rohanbhadange/RTX-AVC-Design/ATTRIBUTION.md

# CAD sources and ownership

This archive contains project CAD and manufacturer/supplier reference geometry. Third-party ownership and any original terms remain with the respective owners. Publication here does not grant a new license or relicense vendor assets. No blanket software or CAD license is asserted for this mixed-source archive.

Native filenames, source directory relationships and CAD bytes are preserved. Imported native assemblies may contain manufacturer component names or historical source-path fragments. Some project representations are envelopes, simplified extractions or standard-hardware approximations; their presence does not establish supplier approval or as-built accuracy.

Identifiable source families include Holybro flight-controller/compute/power hardware, Intel RealSense D455, NVIDIA/Seeed compute geometry, T-Motor propulsion references, Pololu regulators, Basicmicro RoboClaw, Lyn-Tron spacers and standard mounting hardware. Individual component rights remain with their respective owners, including subcomponents in imported supplier assemblies.

Known source/reference sites, supplied for attribution rather than as license grants:

| Source family | Reference |
| --- | --- |
| Holybro power-module/PDB source downloads | https://docs.holybro.com/power-module-and-pdb/power-module/download |
| Holybro flight-controller/compute products | https://holybro.com/ |
| Intel RealSense reference family | https://www.intelrealsense.com/ |
| NVIDIA Jetson reference family | https://developer.nvidia.com/embedded/ |
| Seeed reComputer reference family | https://www.seeedstudio.com/ |
| T-Motor reference family | https://uav-en.tmotor.com/ |
| Pololu reference family | https://www.pololu.com/ |
| Basicmicro reference family | https://www.basicmicro.com/ |
| Lyn-Tron spacer reference family | https://www.lyntron.com/ |

The exact raw exchange sources retained alongside their native counterparts are `Holybro_PDB_18139.step`, `Holybro_PM08_CAN_Case_v003.step`, and `Holybro_Pixhawk_Jetson_11072.step` under `cad/DronePlayground/WORKING/R3_1/VENDOR/`. Their filenames and hashes are recorded in the manifest. No local LICENSE, NOTICE or COPYING files were found in the supplied DronePlayground tree during this checkpoint review; this is not a determination that third-party CAD is unrestricted.
