rohanbhadange/RTX-AVC-Design/CHECKPOINT.md

# Drone Playground engineering checkpoint

Saved baseline: C124, configuration R3_3_PACKAGING. This checkpoint preserves the existing integrated drone assembly. The configuration was saved with SolidWorks error/warning status 0/0 and 82 baseline root signatures preserved. No optimized candidate geometry is installed in this baseline.

The baseline includes the internal power cassette work. The external PM08 arrangement and USB storage fallback remain. Native represented mass is provisional and is not a verified aircraft mass or flight-margin result.

Separate work in progress includes lower/upper plate lightening candidates and a camera-yoke candidate. These are uninstalled studies; candidate mass reductions are not installed aircraft savings. Local geometry and contact screens do not establish structural strength, cable routing, manufacturing readiness or flight qualification.

Packaging and full system integration remain incomplete. Open work includes complete power protection and disconnect interfaces, actual cable/connector retention and harness routing, compute/storage and sensor/radio integration, manufacturing and mechanical load qualification, mass/CG reconciliation, and operating-state and fault-response verification. All previously tracked integration obligations remain open until individually verified.

Any accompanying C122 native views show the earlier internal-power integration state. They are historical views and do not depict installed R3.3 optimizations.
