rohanbhadange/RTX-AVC-Design/cad/DronePlayground/WORKING/R3_1/exports/C178_Compute_Radio_Module.png

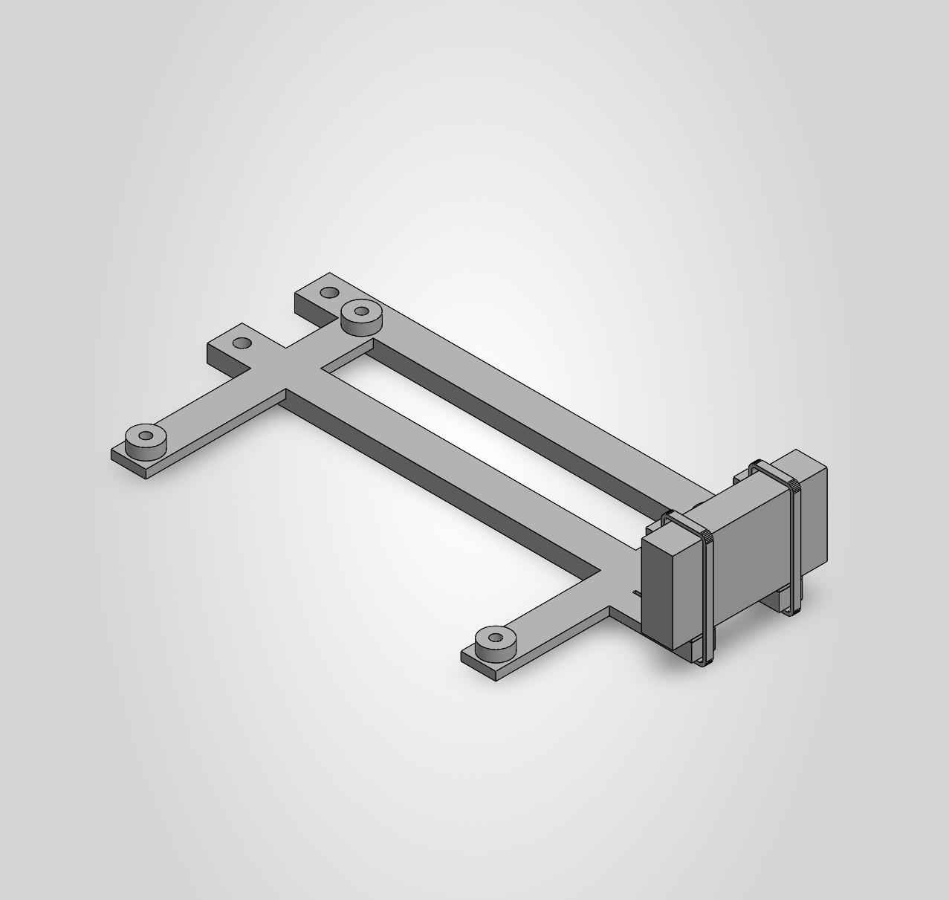
cad/DronePlayground/WORKING/R3_1/exports/C178_Compute_Radio_Module.png
