rohanbhadange/RTX-AVC-Design/cad/DronePlayground/WORKING/R3_1/exports/C180_Radio_Integrated_isometric.png

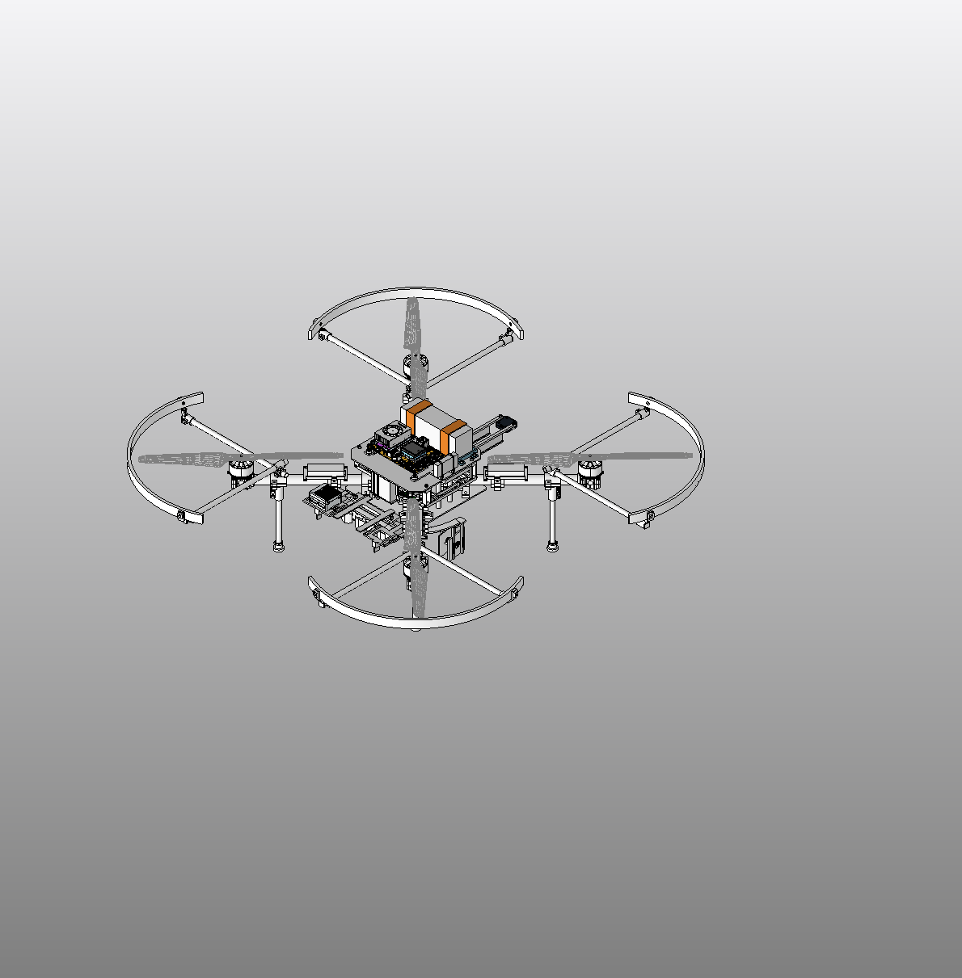
cad/DronePlayground/WORKING/R3_1/exports/C180_Radio_Integrated_isometric.png
