rohanbhadange/RTX-AVC-Design/cad/DronePlayground/WORKING/R3_1/exports/C203_Internal_PM08_Module.png

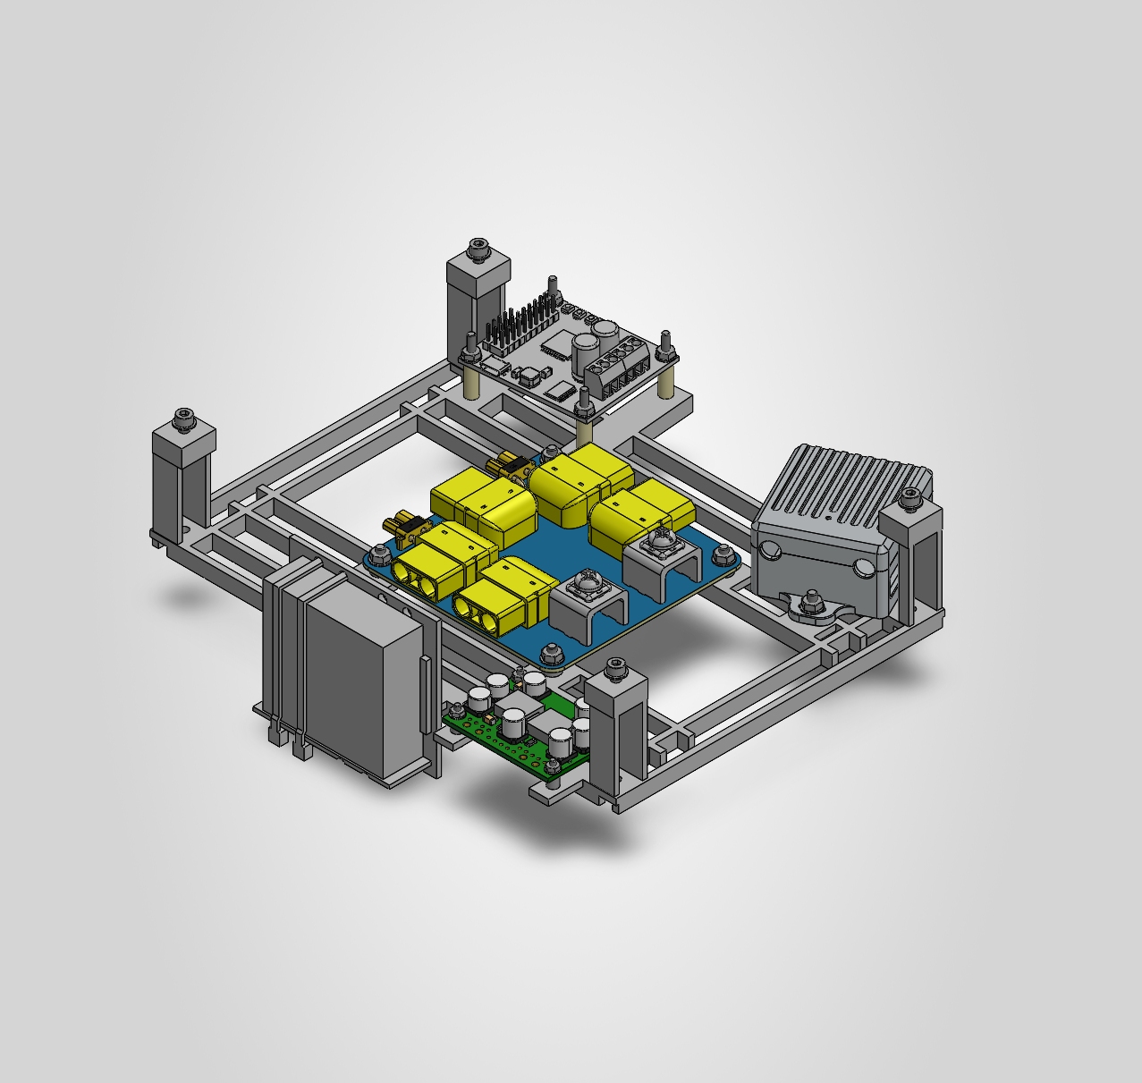
cad/DronePlayground/WORKING/R3_1/exports/C203_Internal_PM08_Module.png
