rohanbhadange/RTX-AVC-Design/diagrams/presentation/01-power-distribution.png

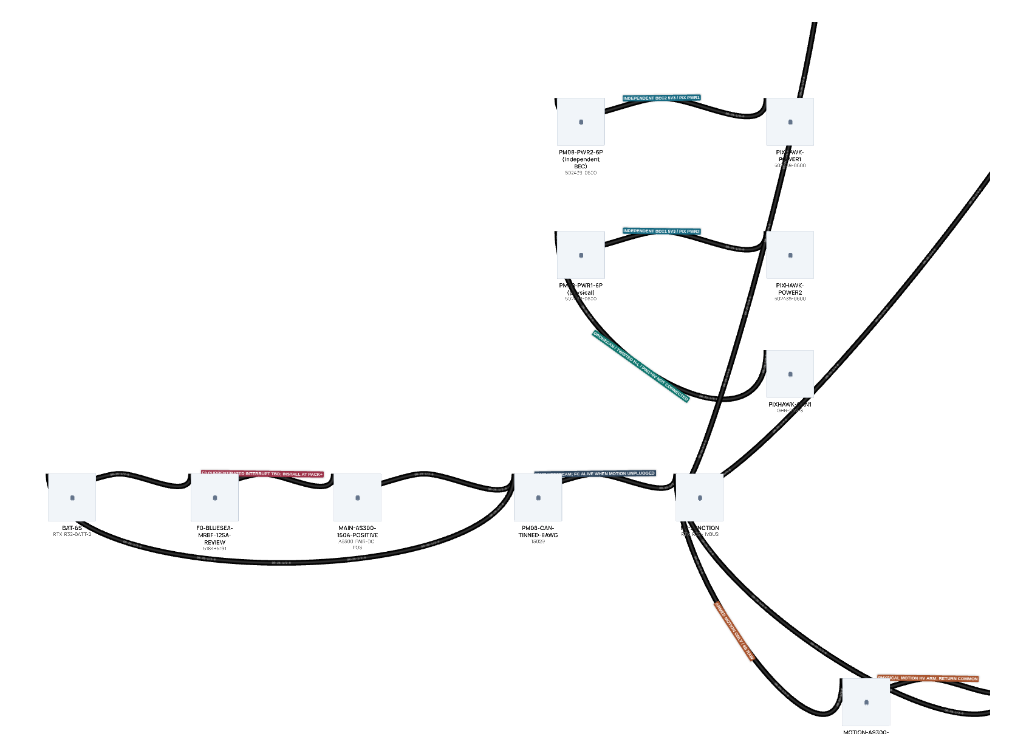
diagrams/presentation/01-power-distribution.png
