rohanbhadange/RTX-AVC-Design/diagrams/presentation/02-compute-brainchip.png

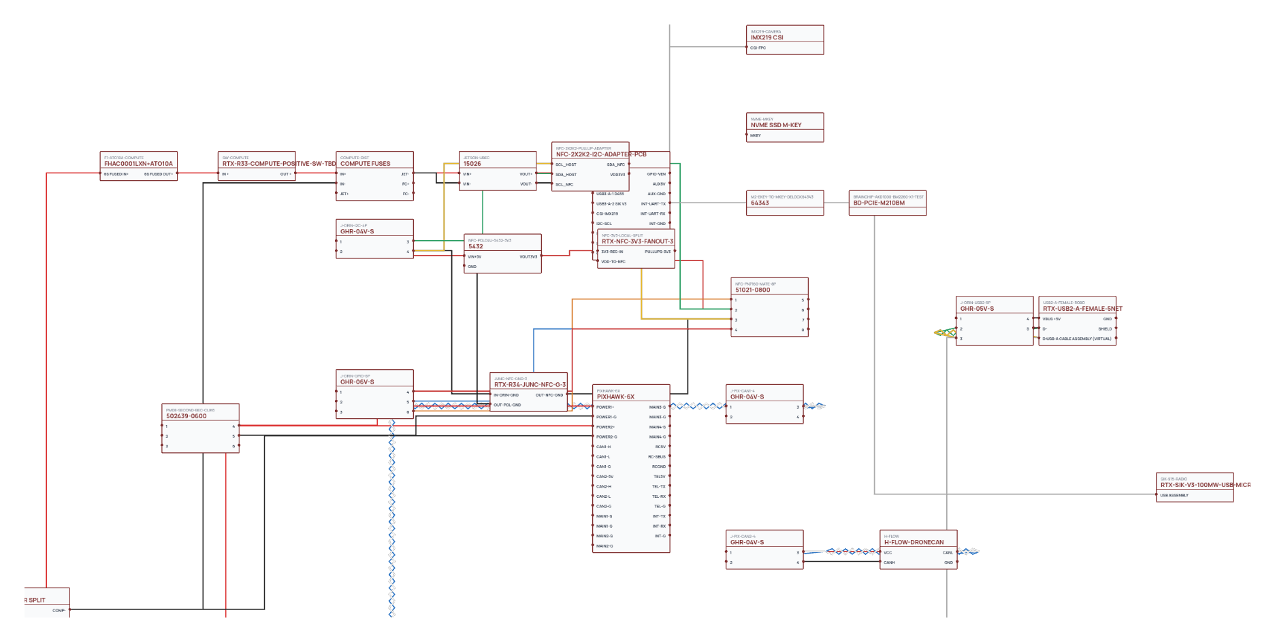
diagrams/presentation/02-compute-brainchip.png
