rohanbhadange/RTX-AVC-Design/diagrams/presentation/03-comms-sensors.png

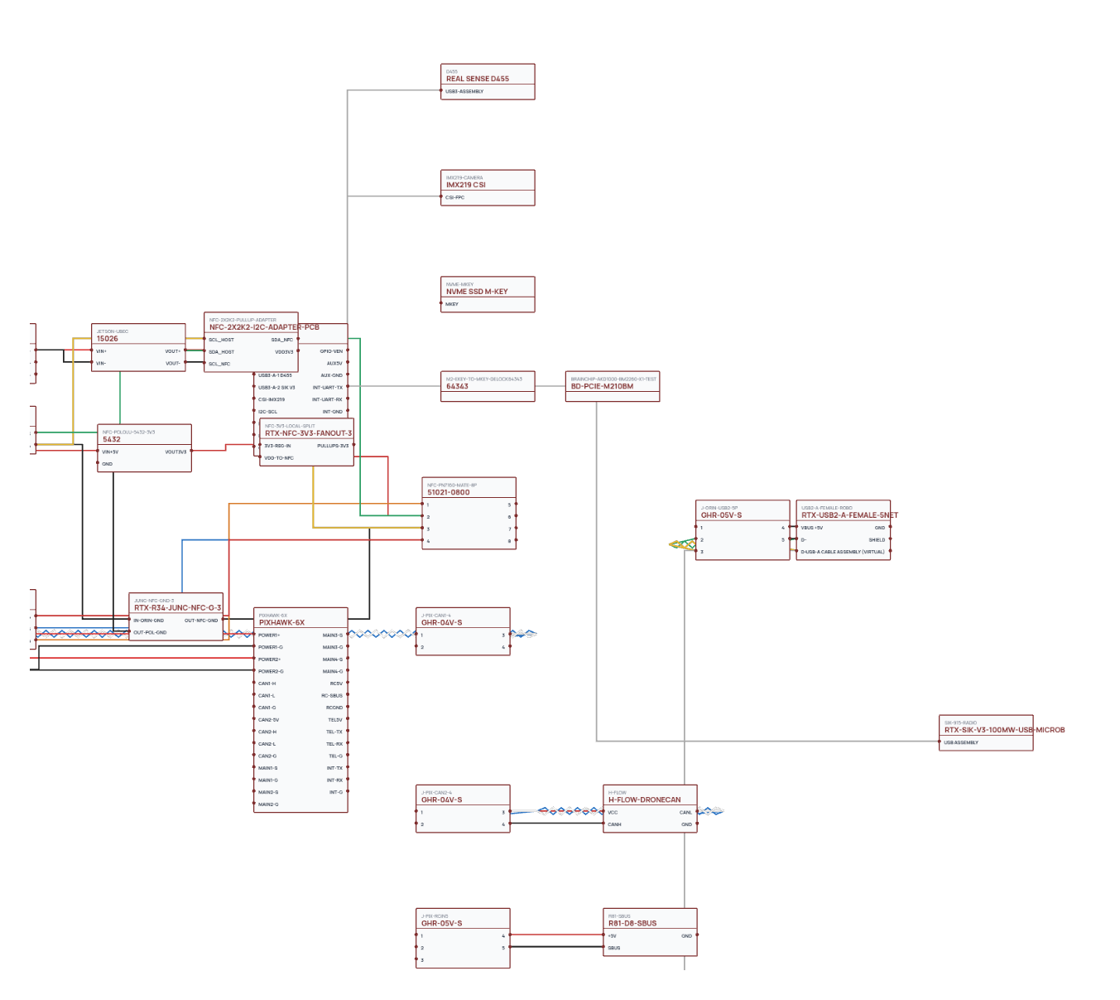
diagrams/presentation/03-comms-sensors.png
