rohanbhadange/RTX-AVC-Design/diagrams/presentation/04-propulsion.png

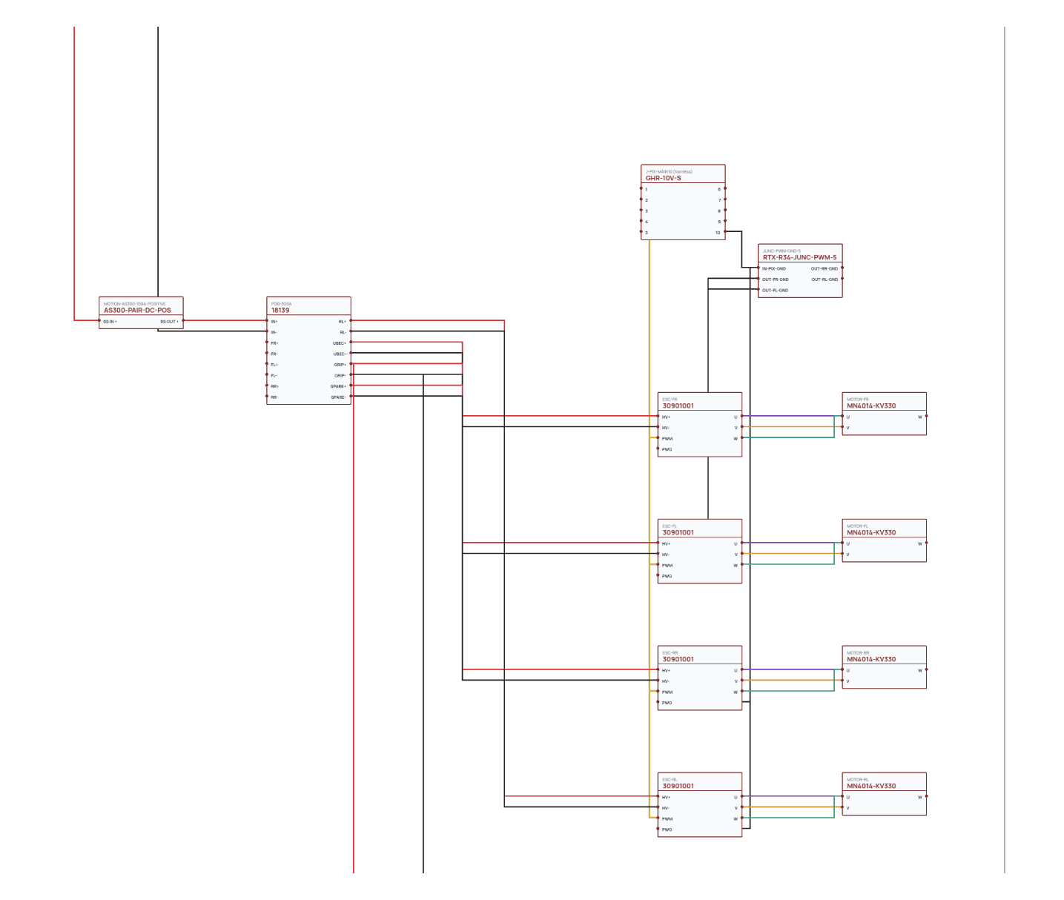
diagrams/presentation/04-propulsion.png
