rohanbhadange/RTX-AVC-Design/diagrams/presentation/05-gripper-control.png

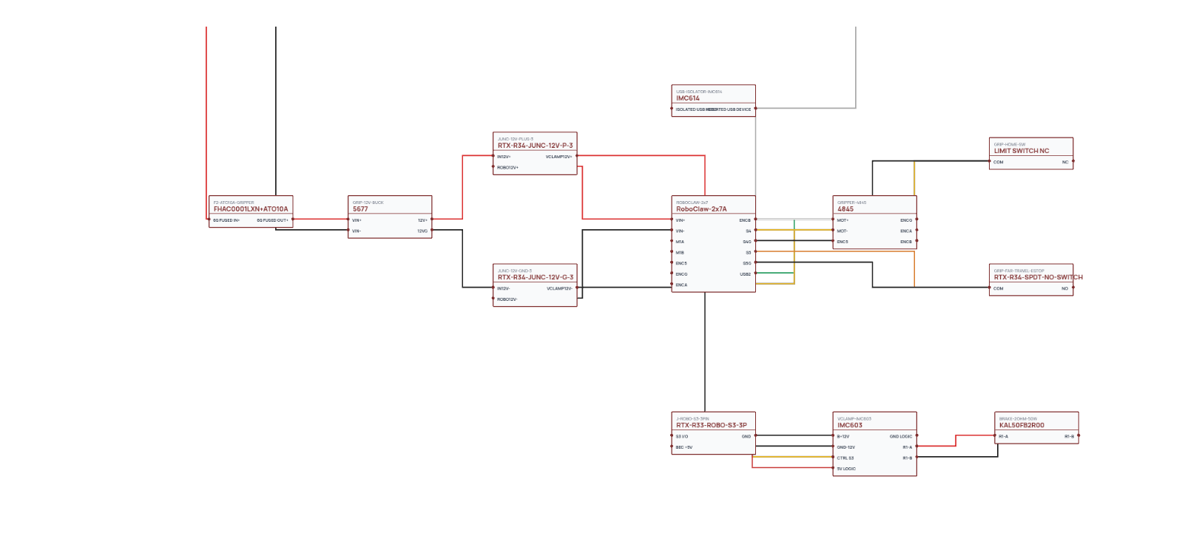
diagrams/presentation/05-gripper-control.png
