rohanbhadange/RTX-AVC-Design/diagrams/wiring-studio/W-100-design.png

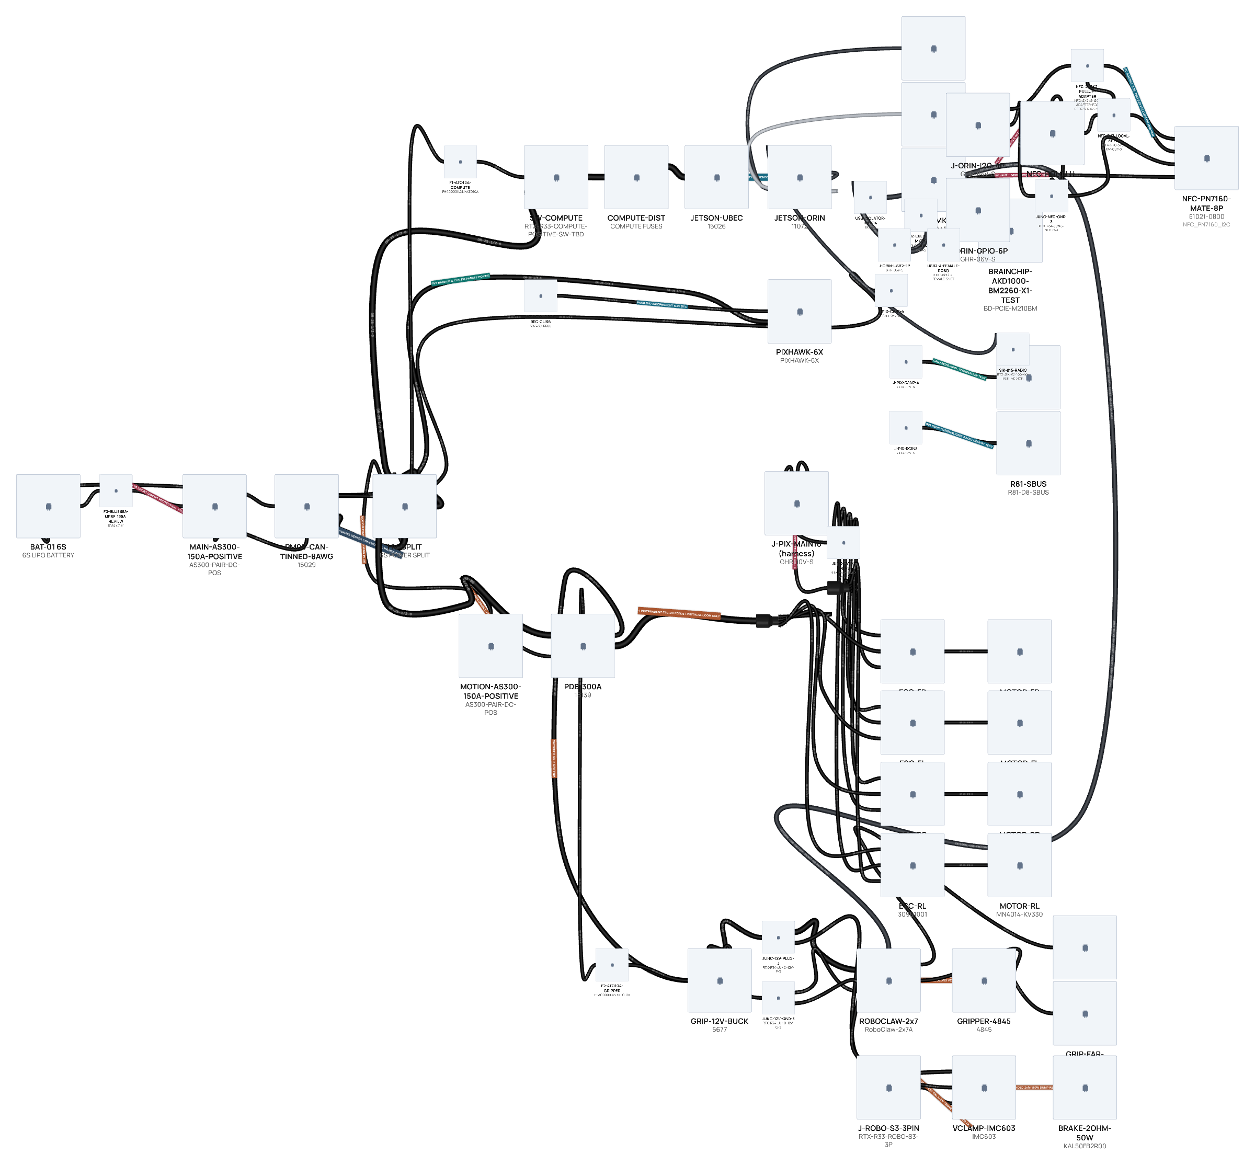
diagrams/wiring-studio/W-100-design.png
