rohanbhadange/RTX-AVC-Design/diagrams/wiring-studio/W-101-design.png

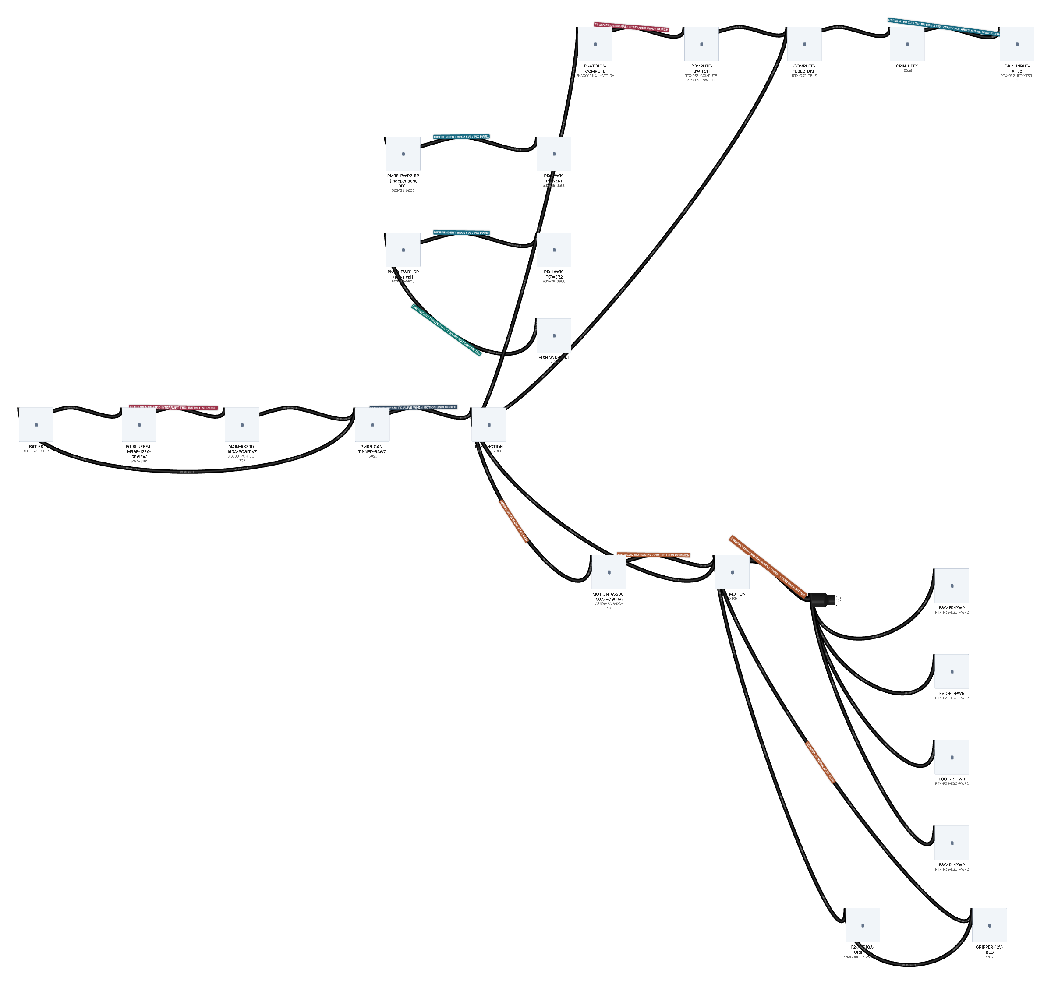
diagrams/wiring-studio/W-101-design.png
