rohanbhadange/RTX-AVC-Design/images/C164_Integrated_Power_Carrier_Candidate.png

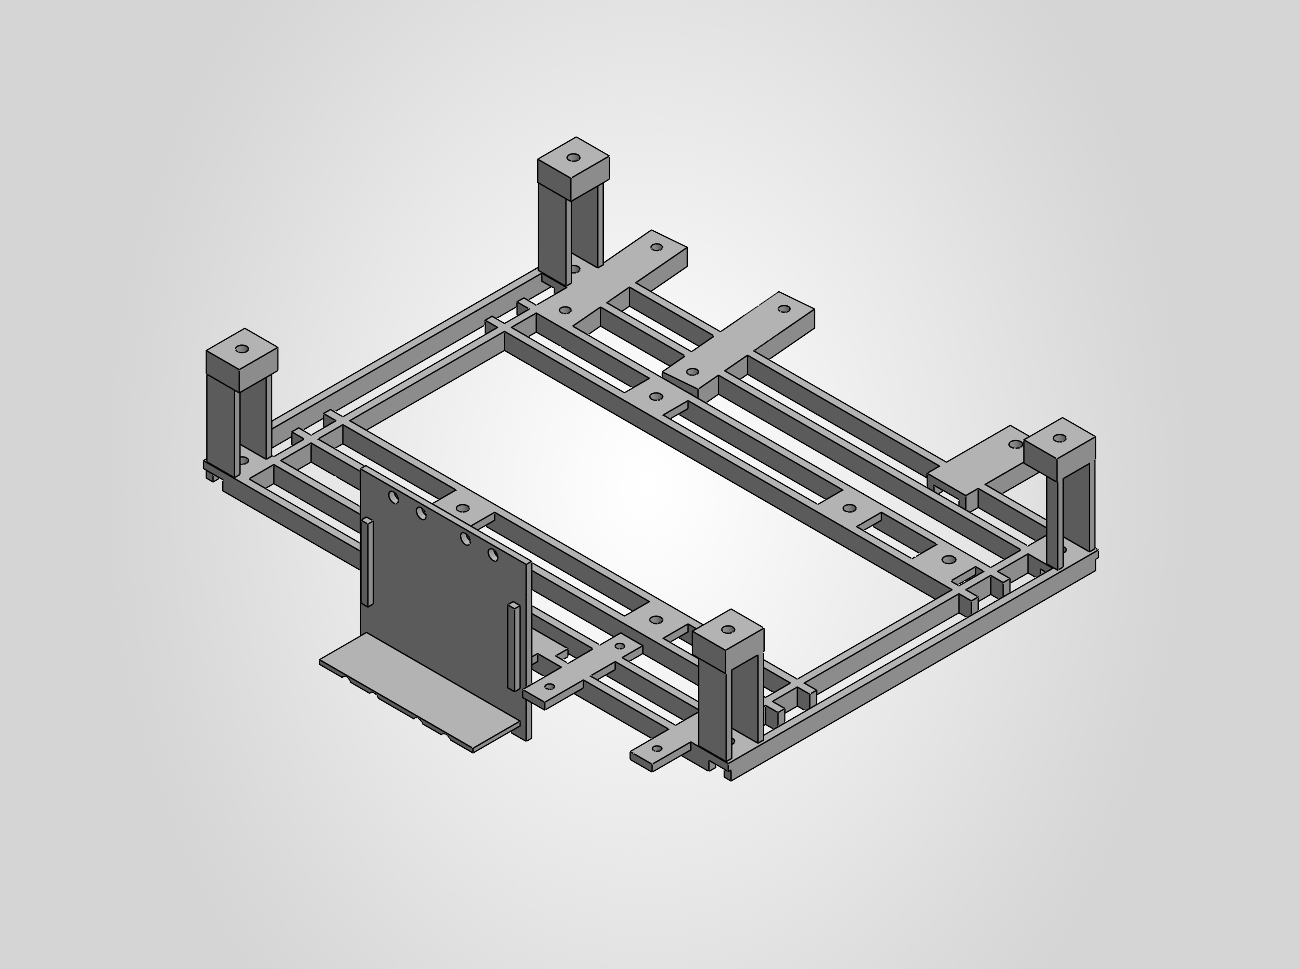
images/C164_Integrated_Power_Carrier_Candidate.png
