rohanbhadange/RTX-AVC-Design/diagrams/generated/W-100-netlist.csv

network | source_component | source_cavity | source_pin | target_component | target_cavity | target_pin | wire_part | twisted_pair_id | wire_id
PACK+ -> F0 DC FUSE IN | BAT-01 6S | 1 | BAT+ | F0-BLUESEA-MRBF-125A-REVIEW | 1 | PACK+ | RTX-R32-W-8R |  | k175tm4c5nhf0nd3hem1e9gcnh8h48b4
6S BATTERY COMMON MINUS -> PM08 INPUT- | BAT-01 6S | 2 | BAT- | PM08-CAN-TINNED-8AWG | 2 | HVIN- | RTX-R32-W-8B |  | k176w81sgqy2hfy5r59nmvewdn8h4rax
UBEC INPUT+ | COMPUTE-DIST | 3 | JET+ | JETSON-UBEC | 1 | VIN+ | RTX-R32-W-16R |  | k17awry4fp9zq7157h7tgy571x8h2jkv
UBEC INPUT- | COMPUTE-DIST | 4 | JET- | JETSON-UBEC | 2 | VIN- | RTX-R32-W-16B |  | k176ka6j6ee17semdsvn561cd98h2arp
MOTOR FL PHASE U | ESC-FL | 5 | U | MOTOR-FL | 1 | U | RTX-R32-W-16PH-U |  | k174pvfp9sht31jnc97dnhft218h2z0n
MOTOR FL PHASE V | ESC-FL | 6 | V | MOTOR-FL | 2 | V | RTX-R32-W-16PH-V |  | k17adf7mee4wvwjrx6rw2hpkqn8h3rkh
MOTOR FL PHASE W | ESC-FL | 7 | W | MOTOR-FL | 3 | W | RTX-R32-W-16PH-W |  | k175yv1m5rr4gwbp98pgk57va58h2d3f
MOTOR FR PHASE U | ESC-FR | 5 | U | MOTOR-FR | 1 | U | RTX-R32-W-16PH-U |  | k172hw591260vh5n7ak083e05x8h20sb
MOTOR FR PHASE V | ESC-FR | 6 | V | MOTOR-FR | 2 | V | RTX-R32-W-16PH-V |  | k174p1a39xqn5qng5gzjty98s18h2yjb
MOTOR FR PHASE W | ESC-FR | 7 | W | MOTOR-FR | 3 | W | RTX-R32-W-16PH-W |  | k17dq0jp94tj2s2d1w7t7qdm3s8h3ezt
MOTOR RL PHASE U | ESC-RL | 5 | U | MOTOR-RL | 1 | U | RTX-R32-W-16PH-U |  | k17fk5gnxhxgttnd52qsb1szh18h2caq
MOTOR RL PHASE V | ESC-RL | 6 | V | MOTOR-RL | 2 | V | RTX-R32-W-16PH-V |  | k170ngnnkr97ngparkwmrrb6658h3006
MOTOR RL PHASE W | ESC-RL | 7 | W | MOTOR-RL | 3 | W | RTX-R32-W-16PH-W |  | k17f6v3fb4q07edsvse6v50b1x8h2szf
MOTOR RR PHASE U | ESC-RR | 5 | U | MOTOR-RR | 1 | U | RTX-R32-W-16PH-U |  | k17f9kzcwevrqha13epzewgbz18h2nmm
MOTOR RR PHASE V | ESC-RR | 6 | V | MOTOR-RR | 2 | V | RTX-R32-W-16PH-V |  | k170tq5dp46x51qd2h5k7rmc4x8h322s
MOTOR RR PHASE W | ESC-RR | 7 | W | MOTOR-RR | 3 | W | RTX-R32-W-16PH-W |  | k175dqr6mb6brbthp10kwstwt18h3vw1
F0 OUT -> MASTER POSITIVE SWITCH | F0-BLUESEA-MRBF-125A-REVIEW | 2 | MAIN CUT+ | MAIN-AS300-150A-POSITIVE | 1 | 6S IN + | RTX-R32-W-8R |  | k17994ryxn9282sxxbpg0t3w1h8h407t
F1 OUT -> COMPUTE SWITCH | F1-ATO10A-COMPUTE | 2 | 6S FUSED OUT+ | SW-COMPUTE | 1 | IN + | RTX-R32-W-16R |  | k1705gvbva31kdd32x5n2cd77d8h4410
F2 FUSED 6S POSITIVE -> 12V GRIPPER REG | F2-ATO10A-GRIPPER | 2 | 6S FUSED OUT+ | GRIP-12V-BUCK | 1 | VIN+ | RTX-R32-W-18R |  | k178ywfvwv6prx7rkyscjj6spn8h5fw0
GRIP BUCK +12 -> 1-2 BRANCH SOLDER JUNCTION | GRIP-12V-BUCK | 3 | 12V+ | JUNC-12V-PLUS-3 | 1 | IN12V+ | RTX-R32-W-18R |  | k175rfrqhr573farzsjbsesc6s8h4n2n
GRIP BUCK -12 -> 1-2 BRANCH SOLDER JUNCTION | GRIP-12V-BUCK | 4 | 12VG | JUNC-12V-GND-3 | 1 | IN12V- | RTX-R32-W-18B |  | k174p1krvkrazvcp66n40gayx98h5d6e
S5 E-STOP SWITCH COM -> S5 GND | GRIP-FAR-TRAVEL-ESTOP | 1 | COM | ROBOCLAW-2x7 | 12 | S5G | RTX-R32-W-26BK |  | k17cqa5r85a332wmqjaqd64e2s8h4q2d
S4 HOME COM RETURN HOLD | GRIP-HOME-SW | 1 | COM | ROBOCLAW-2x7 | 10 | S4G | RTX-R32-W-26BK |  | k17evhwy0a4w5ja198y26bcjps8h23xy
ENC A | GRIPPER-4845 | 5 | ENCA | ROBOCLAW-2x7 | 7 | ENCA | RTX-R32-W-26YL |  | k1724gm3eqcneg8nnpv1g7et6h8h3m31
ENC B | GRIPPER-4845 | 6 | ENCB | ROBOCLAW-2x7 | 8 | ENCB | RTX-R32-W-26WH |  | k172v2dj9rae8pan6p2bytnjqs8h3xgz
MONITORED 6S COMPUTE -> F1 IN | HV-SPLIT | 3 | COMP+ | F1-ATO10A-COMPUTE | 1 | 6S FUSED IN+ | RTX-R32-W-16R |  | k1758fm935v9q33cj2dzd2wnz98h5g96
COMPUTE NEGATIVE / COMMON UNSWITCHED | HV-SPLIT | 4 | COMP- | COMPUTE-DIST | 2 | IN- | RTX-R32-W-16B |  | k1733saak0d0gq9nmv7bbwfqpd8h5ect
6S MOTION BRANCH+ | HV-SPLIT | 5 | MOTION+ | MOTION-AS300-150A-POSITIVE | 1 | 6S IN + | RTX-R32-W-8R |  | k17b6gxwf2qeea2tnpv1v62sqx8h3ec6
COMMON RETURN -> PDB- | HV-SPLIT | 6 | MOTION- | PDB-300A | 2 | IN- | RTX-R32-W-8B |  | k1721er72v9fdayqrrhxdkrn9s8h4z10
ORIN GPIO PIN1 +5V -> PN7160 VANT PIN8 (150mA PEAK CHECK) | J-ORIN-GPIO-6P | 1 | 1 | NFC-PN7160-MATE-8P | 8 | 8 | RTX-R32-W-26RD |  | k17bmn6ew49yp0nr88ngkw5fc98h4dax
ORIN GPIO07 3V3 -> PN7160 IRQ PIN4 | J-ORIN-GPIO-6P | 2 | 2 | NFC-PN7160-MATE-8P | 4 | 4 | RTX-R32-W-26BL |  | k17cb388aex1v67yv73f1xxgk98h2cpk
ORIN GPIO11 3V3 -> PN7160 VEN PIN5 | J-ORIN-GPIO-6P | 3 | 3 | NFC-PN7160-MATE-8P | 5 | 5 | RTX-R32-W-26OR |  | k17b7xmtnxsebasce6vx3fxjb58h2az0
ORIN I2C PIN1 +5V -> POLOLU 5432 VIN | J-ORIN-I2C-4P | 1 | 1 | NFC-POLOLU-5432-3V3 | 1 | VIN+5V | RTX-R32-W-26RD |  | k179vhappkg2kx6mhhvphwy73d8h3ha0
ORIN I2C1 SCL3V3 -> NFC PULLUP SCL IN | J-ORIN-I2C-4P | 2 | 2 | NFC-2X2K2-PULLUP-ADAPTER | 1 | SCL_HOST | RTX-R32-W-26YL |  | k1759dn73hwgfe7ynrm81zjkts8h3j3c
ORIN I2C1 SDA3V3 -> NFC PULLUP SDA IN | J-ORIN-I2C-4P | 3 | 3 | NFC-2X2K2-PULLUP-ADAPTER | 2 | SDA_HOST | RTX-R32-W-26GN |  | k178da199twxcfay94dsas542s8h2bpm
NFC REG VIN RETURN | J-ORIN-I2C-4P | 4 | 4 | JUNC-NFC-GND-3 | 1 | IN-ORIN-GND | RTX-R32-W-26BK |  | k17dkgyjgjwfc7h7pcfky02s8n8h3q4s
USB2 HOST VBUS +5V | J-ORIN-USB2-5P | 1 | 1 | USB2-A-FEMALE-ROBO | 1 | 1 | RTX-R32-W-26RD |  | k1706n0ez0yt7pyxfqpnr19x2n8hgr8q
USB2 HOST D- | J-ORIN-USB2-5P | 2 | 2 | USB2-A-FEMALE-ROBO | 2 | 2 | RTX-R32-W-26GN | tp-k17czsp2518avv813ra8611w218hhqq2-k17ezjvsvgnk0yk39wcy66r9wh8hhtat | k17czsp2518avv813ra8611w218hhqq2
USB2 HOST D+ | J-ORIN-USB2-5P | 3 | 3 | USB2-A-FEMALE-ROBO | 3 | 3 | RTX-R32-W-26YL | tp-k17czsp2518avv813ra8611w218hhqq2-k17ezjvsvgnk0yk39wcy66r9wh8hhtat | k17ezjvsvgnk0yk39wcy66r9wh8hhtat
USB2 HOST GND | J-ORIN-USB2-5P | 4 | 4 | USB2-A-FEMALE-ROBO | 4 | 4 | RTX-R32-W-26BK |  | k17chf17tatdxn5rvthfq1ch2d8hh3qr
USB2 HOST SHIELD | J-ORIN-USB2-5P | 5 | 5 | USB2-A-FEMALE-ROBO | 5 | 5 | RTX-R32-W-26BK |  | k17enejwd67gt6ka0tj6tjn7jd8hgwvx
H-FLOW 5V | J-PIX-CAN2-4 | 1 | 1 | H-FLOW | 1 | VCC | RTX-R32-W-26RD |  | k17dnnt4gqjhb88vtc2362ehfx8h3pzq
H-FLOW CAN2-H | J-PIX-CAN2-4 | 2 | 2 | H-FLOW | 2 | CANH | RTX-R32-W-26BL | tp-k178b05mzhqgp37ezeatrc3yxn8h2j1a-k17abnspsak9s10nct90wwv8v98h2pg0 | k17abnspsak9s10nct90wwv8v98h2pg0
H-FLOW CAN2-L | J-PIX-CAN2-4 | 3 | 3 | H-FLOW | 3 | CANL | RTX-R32-W-26WH | tp-k178b05mzhqgp37ezeatrc3yxn8h2j1a-k17abnspsak9s10nct90wwv8v98h2pg0 | k178b05mzhqgp37ezeatrc3yxn8h2j1a
H-FLOW GND | J-PIX-CAN2-4 | 4 | 4 | H-FLOW | 4 | GND | RTX-R32-W-26BK |  | k179svbb8160vesyetescn1q118h22g0
PWM1 FR HOLD PX4 MAP | J-PIX-MAIN10 (harness) | 2 | 2 | ESC-FR | 3 | PWM | RTX-R32-W-26YL |  | k179hx2p377fpqqb3drg8cxwdx8h2gzs
PWM2 FL HOLD PX4 MAP | J-PIX-MAIN10 (harness) | 3 | 3 | ESC-FL | 3 | PWM | RTX-R32-W-26YL |  | k17awzghpjyfsaxp5ftce8zdjn8h3qbd
PWM3 RR HOLD PX4 MAP | J-PIX-MAIN10 (harness) | 4 | 4 | ESC-RR | 3 | PWM | RTX-R32-W-26YL |  | k179q8a090qdr2rekzjx7jy4c58h2xnq
PWM4 RL HOLD PX4 MAP | J-PIX-MAIN10 (harness) | 5 | 5 | ESC-RL | 3 | PWM | RTX-R32-W-26YL |  | k17ejgshcy5s38nm1nbs471n958h23pe
PWM MAIN10 SINGLE GND -> 1-4 STRAIN-RELIEVED SPLICE | J-PIX-MAIN10 (harness) | 10 | 10 | JUNC-PWM-GND-5 | 1 | IN-PIX-GND | RTX-R32-W-26BK |  | k17dt8kx8fvn8sw8fq809wjbax8h49sp
RC +5V | J-PIX-RCIN5 | 1 | 1 | R81-SBUS | 1 | +5V | RTX-R32-W-26RD |  | k1763h0yrvddda1tftfx5en3758h2t71
ROBO S3 -> VCLAMP CTRL (INVERTED CONFIG) | J-ROBO-S3-3PIN | 1 | S3 I/O | VCLAMP-IMC603 | 3 | CTRL S3 | RTX-R32-W-26YL |  | k1787ebqv9d18mz1frt087fadx8h5932
ROBO S3 HEADER BEC 5V -> VCLAMP 5V | J-ROBO-S3-3PIN | 2 | BEC +5V | VCLAMP-IMC603 | 4 | 5V LOGIC | RTX-R32-W-26RD |  | k17afqbceam0asqd9f923q2x898h4s3h
ROBO S3 HEADER GND -> VCLAMP LOGIC GND | J-ROBO-S3-3PIN | 3 | GND | VCLAMP-IMC603 | 5 | GND LOGIC | RTX-R32-W-26BK |  | k171gce3v0wwh9wfxp1h2jsh558h52kx
FACTORY USB3 D455 CABLE NOT PINOUT | JETSON-ORIN | 3 | USB3-A-1 D455 | D455 | 1 | USB3-ASSEMBLY | RTX-R32-W-ASSEMBLY |  | k17e526b9dy525nr2j5nxery2x8h2m1p
USB3 HOST A2 -> SIK V3 USB-MICROB FACTORY CABLE (5V+DATA) | JETSON-ORIN | 4 | USB3-A-2 SIK V3 | SIK-915-RADIO | 1 | USB ASSEMBLY | RTX-R32-W-ASSEMBLY |  | k1749e733gy397qgm8t2kg7ev98hhkwp
CSI FFC ADAPTER HOLD | JETSON-ORIN | 5 | CSI-IMX219 | IMX219-CAMERA | 1 | CSI-FPC | RTX-R32-W-ASSEMBLY |  | k173xymck1rxymjc2ax5wps46d8h2vg2
JETSON 7.2V REGULATED IN + (HOLYBRO SETTING) | JETSON-UBEC | 3 | VOUT+ | JETSON-ORIN | 1 | VIN+ | RTX-R32-W-18R |  | k179948zhq9wqg0nr4edbkdbn98h2r3t
JETSON RETURN | JETSON-UBEC | 4 | VOUT- | JETSON-ORIN | 2 | VIN- | RTX-R32-W-18B |  | k1778apb9x3f4eh7k938m8pzz58h3zdw
REG 12V ROBOCLAW RETURN | JUNC-12V-GND-3 | 2 | ROBO12V- | ROBOCLAW-2x7 | 2 | VIN- | RTX-R32-W-18B |  | k17d8kac1jxgf8w1kyagj6zd1h8h3y5g
REG12 GND TO VCLAMP POWER TAP HOLD | JUNC-12V-GND-3 | 3 | VCLAMP12V- | VCLAMP-IMC603 | 2 | GND-12V | RTX-R32-W-18B |  | k17evxxds4sv7m1hyqd04qgm418h5vd4
REG 12V ROBOCLAW+ | JUNC-12V-PLUS-3 | 2 | ROBO12V+ | ROBOCLAW-2x7 | 1 | VIN+ | RTX-R32-W-18R |  | k1751trnqj9pvcxp6x44wwftm18h35c0
REG12 + TO VCLAMP B+ POWER TAP HOLD | JUNC-12V-PLUS-3 | 3 | VCLAMP12V+ | VCLAMP-IMC603 | 1 | B+12V | RTX-R32-W-18R |  | k1751gq4kh59xp45whzf3kv67h8h5s22
SINGLE 26AWG SPLICE -> NFC REGULATOR GND PAD | JUNC-NFC-GND-3 | 2 | OUT-POL-GND | NFC-POLOLU-5432-3V3 | 2 | GND | RTX-R32-W-26BK |  | k171yksq18px6a60szvgx6ctm58h527s
NFC GND | JUNC-NFC-GND-3 | 3 | OUT-NFC-GND | NFC-PN7160-MATE-8P | 7 | 7 | RTX-R32-W-26BK |  | k17by0a3rqzyrqhv0kxa8pbg018h3ztx
PWM FR GND | JUNC-PWM-GND-5 | 2 | OUT-FR-GND | ESC-FR | 4 | PWG | RTX-R32-W-26BK |  | k177qad22tvz1rcabapefmawpd8h20sp
PWM FL GND | JUNC-PWM-GND-5 | 3 | OUT-FL-GND | ESC-FL | 4 | PWG | RTX-R32-W-26BK |  | k17d35ccdx7qp106ymsbpqmsxh8h2gk8
PWM RR GND | JUNC-PWM-GND-5 | 4 | OUT-RR-GND | ESC-RR | 4 | PWG | RTX-R32-W-26BK |  | k1707gymk4nb2es9eef3783kdd8h2z16
PWM RL GND | JUNC-PWM-GND-5 | 5 | OUT-RL-GND | ESC-RL | 4 | PWG | RTX-R32-W-26BK |  | k1703n6ad69w12218ysqcampp58h2ka9
6S MAIN SWITCHED -> PM08 INPUT+ | MAIN-AS300-150A-POSITIVE | 2 | 6S OUT + | PM08-CAN-TINNED-8AWG | 1 | HVIN+ | RTX-R32-W-8R |  | k179q3s9kvwye59jc0z96wpacs8h4d6c
ARMING SWITCH POWER -> PDB+ | MOTION-AS300-150A-POSITIVE | 2 | 6S OUT + | PDB-300A | 1 | IN+ | RTX-R32-W-8R |  | k175wst31wqtkjnpcf4gvcjhbd8h4ktx
SCL PULLUP PCB OUT -> PN7160 SCL3 | NFC-2X2K2-PULLUP-ADAPTER | 3 | SCL_NFC | NFC-PN7160-MATE-8P | 3 | 3 | RTX-R32-W-26YL |  | k179317dev1r5rsrzpd3835dbd8h401s
SDA PULLUP PCB OUT -> PN7160 SDA2 | NFC-2X2K2-PULLUP-ADAPTER | 4 | SDA_NFC | NFC-PN7160-MATE-8P | 2 | 2 | RTX-R32-W-26GN |  | k177n81wsbhsk75etfd4mnqrbn8h5mbr
NFC VDD 3V3 | NFC-3V3-LOCAL-SPLIT | 2 | VDD-TO-NFC | NFC-PN7160-MATE-8P | 6 | 6 | RTX-R32-W-26RD |  | k176j2bz9nq6vx1nc8yyvbvzbn8h38c6
NFC 3V3 -> 2X2K2 PULLUP PCB | NFC-3V3-LOCAL-SPLIT | 3 | PULLUPS-3V3 | NFC-2X2K2-PULLUP-ADAPTER | 5 | VDD3V3 | RTX-R32-W-26RD |  | k1778z414xa4ky2mjnky7q4cq18h5ja5
NFC LOCAL 3V3 REG -> FANOUT | NFC-POLOLU-5432-3V3 | 3 | VOUT3V3 | NFC-3V3-LOCAL-SPLIT | 1 | 3V3-REG-IN | RTX-R32-W-26RD |  | k170hkt0tv4gpgqxtt9r4af0kd8h5p6e
6S ESC FR+ | PDB-300A | 3 | FR+ | ESC-FR | 1 | HV+ | RTX-R32-W-16R |  | k17cfdzm90x0wdhf3gd0vq4dz58h2n0y
6S ESC FR- | PDB-300A | 4 | FR- | ESC-FR | 2 | HV- | RTX-R32-W-16B |  | k170qbdfah937wcy6sy8vg99bs8h37h0
6S ESC FL+ | PDB-300A | 5 | FL+ | ESC-FL | 1 | HV+ | RTX-R32-W-16R |  | k17eptd2vnatb1varz9r4c3m998h241q
6S ESC FL- | PDB-300A | 6 | FL- | ESC-FL | 2 | HV- | RTX-R32-W-16B |  | k17811e6h9dd68ceksqh1bra1x8h2qpw
6S ESC RR+ | PDB-300A | 7 | RR+ | ESC-RR | 1 | HV+ | RTX-R32-W-16R |  | k178739r8rk5f0fa8068dsravh8h2q92
6S ESC RR- | PDB-300A | 8 | RR- | ESC-RR | 2 | HV- | RTX-R32-W-16B |  | k179nvc839kmd3619exsb42qpx8h391h
6S ESC RL+ | PDB-300A | 9 | RL+ | ESC-RL | 1 | HV+ | RTX-R32-W-16R |  | k17702rq4p7np6nxdpzz3g2wd98h2rtm
6S ESC RL- | PDB-300A | 10 | RL- | ESC-RL | 2 | HV- | RTX-R32-W-16B |  | k17fhsm03mwzkp5ry2nxxrcy5x8h3b0p
6S GRIPPER BUCK+ | PDB-300A | 13 | GRIP+ | F2-ATO10A-GRIPPER | 1 | 6S FUSED IN+ | RTX-R32-W-18R |  | k17c2e2p7zfc5wfs4f51n919n18h3q63
6S GRIPPER BUCK- | PDB-300A | 14 | GRIP- | GRIP-12V-BUCK | 2 | VIN- | RTX-R32-W-18B |  | k171tx0ngmp6m9dj8rgtvjxj3h8h33cy
PM08 SENSED HIGH CURRENT -> HV SPLIT+ | PM08-CAN-TINNED-8AWG | 3 | HVOUT+ | HV-SPLIT | 1 | IN+ | RTX-R32-W-8R |  | k1727tyjbvb414bka822y8v7fs8h4bph
PM08 COMMON RETURN -> HV SPLIT- | PM08-CAN-TINNED-8AWG | 4 | HVOUT- | HV-SPLIT | 2 | IN- | RTX-R32-W-8B |  | k171qh0bfdc05828hn510jxrm18h4ymt
PM08 5.3V BACKUP PWR2 | PM08-CAN-TINNED-8AWG | 5 | BEC1+ | PIXHAWK-6X | 3 | POWER2+ | RTX-R32-W-22R |  | k177xj0wz55pb8f9trg2wafjes8h34j7
PM08 BACKUP PWR2 GND | PM08-CAN-TINNED-8AWG | 6 | BEC1- | PIXHAWK-6X | 4 | POWER2-G | RTX-R32-W-22B |  | k177s5xa65n98yx5jddr7qkhvx8h3wy0
PM08 CAN1-H | PM08-CAN-TINNED-8AWG | 7 | CANH | J-PIX-CAN1-4 | 2 | 2 | RTX-R32-W-26BL | tp-k173ykxk5vrnpkvgzgzkzjncws8h3674-k177bvwctbm9602enq30kp9e458h2xw3 | k177bvwctbm9602enq30kp9e458h2xw3
PM08 CAN1-L | PM08-CAN-TINNED-8AWG | 8 | CANL | J-PIX-CAN1-4 | 3 | 3 | RTX-R32-W-26WH | tp-k173ykxk5vrnpkvgzgzkzjncws8h3674-k177bvwctbm9602enq30kp9e458h2xw3 | k173ykxk5vrnpkvgzgzkzjncws8h3674
PM08 BEC2 5V3 -> PIX POWER1+ (PRIMARY) | PM08-SECOND-BEC-CLIK6 | 1 | 1 | PIXHAWK-6X | 1 | POWER1+ | RTX-R32-W-22R |  | k17dk6k1csqzbdwkt3hd39v12x8h5mtg
PM08 BEC2 GND -> PIX POWER1- (PRIMARY) | PM08-SECOND-BEC-CLIK6 | 5 | 5 | PIXHAWK-6X | 2 | POWER1-G | RTX-R32-W-22B |  | k17d57fzds2p0dr32wrq9dvgr98h5aba
RC SBUS SIGNAL | R81-SBUS | 2 | SBUS | J-PIX-RCIN5 | 2 | 2 | RTX-R32-W-26YL |  | k171cfwbp4gv753ebt25dmjajn8h365d
RC GND | R81-SBUS | 3 | GND | J-PIX-RCIN5 | 5 | 5 | RTX-R32-W-26BK |  | k17dwdhv9magd97p087favvtc58h3t3g
GRIPPER MOTOR M1A | ROBOCLAW-2x7 | 3 | M1A | GRIPPER-4845 | 1 | MOT+ | RTX-R32-W-18R |  | k17cv7dfvy0477ajda0p0ryecd8h3me5
GRIPPER MOTOR M1B | ROBOCLAW-2x7 | 4 | M1B | GRIPPER-4845 | 2 | MOT- | RTX-R32-W-18B |  | k17cva5z3r83zhv1jzk4asd9958h2aqd
ENC +5V | ROBOCLAW-2x7 | 5 | ENC5 | GRIPPER-4845 | 3 | ENC5 | RTX-R32-W-26BL |  | k17b45sr5chs83a7vveg3bbgvx8h2dr9
ENC GND | ROBOCLAW-2x7 | 6 | ENCG | GRIPPER-4845 | 4 | ENCG | RTX-R32-W-26GN |  | k170q6cta960gvy7966tay9egn8h22dg
S4 HOME NC CONTACT | ROBOCLAW-2x7 | 9 | S4 | GRIP-HOME-SW | 2 | NC | RTX-R32-W-26YL |  | k17edekx7jnd4qyqfjy4cwr28h8h32nq
S5 I/O GLOBAL E-STOP ACTIVE-LOW TO FAR LIMIT NO | ROBOCLAW-2x7 | 11 | S5 | GRIP-FAR-TRAVEL-ESTOP | 2 | NO | RTX-R32-W-26OR |  | k17483w6ffabmy0jv3qwct3qv18h5yez
SWITCHED COMPUTE+ | SW-COMPUTE | 2 | OUT + | COMPUTE-DIST | 1 | IN+ | RTX-R32-W-16R |  | k17cma7mnjqtj7vp3tfrp87nas8h2ykh
IMC614 DEVICE PORT -> ROBOCLAW MICRO-B (FACTORY USB) | USB-ISOLATOR-IMC614 | 2 | ISOLATED USB DEVICE | ROBOCLAW-2x7 | 13 | USB2 | RTX-R32-W-ASSEMBLY |  | k175nw4mcb4jkrd0gt5dbe3fdd8h4wvp
VIRTUAL COMPOSITE USB2-A SOCKET -> IMC614 MICRO-B VIA FACTORY CABLE | USB2-A-FEMALE-ROBO | 6 | 6 | USB-ISOLATOR-IMC614 | 1 | ISOLATED USB HOST | RTX-R32-W-ASSEMBLY |  | k1734ah5rbvxhnmhcmm3zw7w4h8hh915
VCLAMP R1A -> 2OHM DUMP RESISTOR A | VCLAMP-IMC603 | 6 | R1-A | BRAKE-2OHM-50W | 1 | R1-A | RTX-R32-W-18R |  | k17cj6y15apda86fkx8ez9m9458h5dnc
VCLAMP R1B -> 2OHM DUMP RESISTOR B | VCLAMP-IMC603 | 7 | R1-B | BRAKE-2OHM-50W | 2 | R1-B | RTX-R32-W-18B |  | k1707s369zpmrtkkgh67699yrh8h4s97
