rohanbhadange/RTX-AVC-Design/(list of files, cad)

Other CAD files:
cad/DronePlayground/Holybro_Pixhawk_Jetson/XT30PW-F_ASM_1_ASM.step.SLDASM
cad/DronePlayground/WORKING/R3_1/CAD/CUSTOM/R01/Gripper/Worm_Gripper_R01.SLDASM
cad/DronePlayground/WORKING/R3_1/CUSTOM/R3_2/Packaging/R3_2_PM08_Cassette_Fastener_Kit.SLDASM
cad/DronePlayground/WORKING/R3_1/DronePlayground.SLDASM
cad/DronePlayground/WORKING/R3_1/CAD/CUSTOM/R01/Arms/Arm_R01.SLDASM
cad/DronePlayground/WORKING/R3_1/CUSTOM/R3_1/Packaging/R3_1_Gripper_Mount.SLDASM
cad/DronePlayground/WORKING/R3_1/CUSTOM/R3_2/Packaging/R3_2_Frame_Fasteners_75mm_FullStack.SLDASM
cad/DronePlayground/Holybro_Pixhawk_Jetson/3D_PDB02-V1_1A_2024-12-06_ASM_1_ASM.step.SLDASM
cad/DronePlayground/WORKING/R3_1/CUSTOM/R3_3/Packaging/R3_3_D455_Service_Mount.SLDASM
cad/DronePlayground/Holybro_Pixhawk_Jetson/PDB-XT90PB-F_ASM_5_ASM.step.SLDASM
cad/DronePlayground/WORKING/R3_1/CAD/Gripper/START_HERE/Components/PLAY_07_FLOAT_LEFT_CONTACT_PAD.SLDASM
cad/DronePlayground/WORKING/R3_1/CUSTOM/R3_2/Packaging/R3_2_PDB_PCB_Fastener_Kit.SLDASM
cad/DronePlayground/WORKING/R3_1/PLACEHOLDERS/R3_2/Holybro15026_CNC_FullBound49x46p4x16p3_APPROX.SLDPRT
cad/DronePlayground/Holybro_Pixhawk_Jetson/5OVZ-J20_ASM_1_ASM.step.SLDASM
cad/DronePlayground/WORKING/R3_1/CUSTOM/R3_2/Packaging/R3_2_RoboClaw_PCB_Fastener_Kit_H12_A275.SLDASM
cad/DronePlayground/WORKING/R3_1/CUSTOM/R3_3/Packaging/R3_3_Internal_Power_PM08.SLDASM
cad/DronePlayground/WORKING/R3_1/CUSTOM/R3_1/Packaging/R3_1_Frame_Fasteners.SLDASM
cad/DronePlayground/WORKING/R3_1/CUSTOM/R3_3/Packaging/R3_3_Compute_Radio_Mount.SLDASM
cad/DronePlayground/Holybro_Pixhawk_Jetson/XT90-PW-F_ASM_1_ASM.step.SLDASM
cad/DronePlayground/Holybro_Pixhawk_Jetson/5OVZ-J28_ASM_1_ASM.step.SLDASM
cad/DronePlayground/WORKING/R3_1/CAD/Gripper/START_HERE/Components/PLAY_03_FLOAT_LEFT_JAW.SLDASM
cad/DronePlayground/WORKING/R3_1/CUSTOM/R3_2/Packaging/R3_2_Battery_Guide_Fasteners.SLDASM
cad/DronePlayground/WORKING/R3_1/CUSTOM/R3_3/Packaging/R3_3_Internal_Power_Carrier.SLDASM
cad/DronePlayground/WORKING/R3_1/CUSTOM/R3_1/Packaging/R3_1_HFlow_Mount.SLDASM
cad/DronePlayground/WORKING/R3_1/CUSTOM/R3_2/Packaging/R3_2_Internal_Power_Cassette_WIP.SLDASM
cad/DronePlayground/Holybro_Pixhawk_Jetson/PCB-104M5_ASM_1_ASM.step.SLDASM
cad/DronePlayground/WORKING/R3_1/CUSTOM/R3_2/Packaging/R3_2_Regulator_PCB_Fastener_Kit_Z63p5.SLDASM
cad/DronePlayground/Holybro_Pixhawk_Jetson/PCBMODEL_1_ASM_1_ASM_2_ASM.step.SLDASM
cad/DronePlayground/Holybro_Pixhawk_Jetson/5OVZ-J26_ASM_1_ASM.step.SLDASM
cad/DronePlayground/WORKING/R3_1/CUSTOM/R3_2/Packaging/R3_2_Internal_Cassette_Hanger_Kit.SLDASM
cad/DronePlayground/Holybro_Pixhawk_Jetson/5OVZ-J22_ASM_1_ASM.step.SLDASM
cad/DronePlayground/Holybro_Pixhawk_Jetson/5OVZ-J24_ASM_1_ASM.step.SLDASM
cad/DronePlayground/Holybro_Pixhawk_Jetson/PCBMODEL_1_ASM_1_ASM.step.SLDASM
cad/DronePlayground/Holybro_Pixhawk_Jetson/5OVZ-J21_ASM_1_ASM.step.SLDASM
cad/DronePlayground/WORKING/R3_1/CAD/Gripper/START_HERE/Components/PLAY_01_FIXED_FRAME.SLDASM
cad/DronePlayground/Holybro_Pixhawk_Jetson/5OVZ-J25_ASM_1_ASM.step.SLDASM
cad/DronePlayground/Holybro_Pixhawk_Jetson/5OVZ-J29_ASM_1_ASM.step.SLDASM
cad/DronePlayground/Holybro_Pixhawk_Jetson/5OVZ-J23_ASM_1_ASM.step.SLDASM
cad/DronePlayground/WORKING/R3_1/CAD/Gripper/START_HERE/Components/PLAY_04_FLOAT_RIGHT_JAW.SLDASM
cad/DronePlayground/Holybro_Pixhawk_Jetson/LUOSI_ASM.step.SLDASM
cad/DronePlayground/WORKING/R3_1/CAD/Gripper/START_HERE/Components/PLAY_05_FLOAT_LEFT_PAD_HOUSING.SLDASM
cad/DronePlayground/WORKING/R3_1/CAD/Gripper/START_HERE/Components/PLAY_06_FLOAT_RIGHT_PAD_HOUSING.SLDASM
cad/DronePlayground/WORKING/R3_1/CAD/Gripper/START_HERE/Components/PLAY_08_FLOAT_RIGHT_CONTACT_PAD.SLDASM
cad/DronePlayground/WORKING/R3_1/CAD/Gripper/START_HERE/Components/PLAY_02_FLOAT_WORM_DRIVE.SLDASM
cad/DronePlayground/WORKING/R3_1/CAD/CUSTOM/R01/Arms/Arm_Root_Upper_R01.SLDPRT
cad/DronePlayground/WORKING/R3_1/CAD/CUSTOM/R01/Chassis/CF_Centre_Plate_Lower_R01.SLDPRT
cad/DronePlayground/WORKING/R3_1/CAD/Gripper/START_HERE/Components/PLAY_14_Pivot_Shaft.SLDPRT
cad/DronePlayground/WORKING/R3_1/CAD/Holybro_H_Flow/H_Flow_DroneCAN.SLDPRT
cad/DronePlayground/WORKING/R3_1/CAD/Holybro_X650_Motor_Mount/Holybro_X650_Motor_Mount_Upper.SLDPRT
cad/DronePlayground/WORKING/R3_1/CAD/PLACEHOLDERS/Prop_Guard_15p5in_PH_Parametric_ID413p7_OD425p7_H20_QTY4.SLDPRT
cad/DronePlayground/WORKING/R3_1/CAD/Pololu_D42V110F12/Pololu_D42V110F12.SLDPRT
cad/DronePlayground/WORKING/R3_1/CAD/TMotor_MN4014_KV330/MN4014_X650_Manufacturer_Reference.SLDPRT
cad/DronePlayground/WORKING/R3_1/CAD/TMotor_MS1503/MS1503_Manufacturer_Graphics_Reference.SLDPRT
cad/DronePlayground/WORKING/R3_1/CUSTOM/R3_1/Arms/RTX-R3.1-DP-GUARD-014.SLDPRT
cad/DronePlayground/WORKING/R3_1/CUSTOM/R3_1/Landing/RTX-R3.1-DP-LAND-002.SLDPRT
cad/DronePlayground/WORKING/R3_1/CUSTOM/R3_1/Packaging/RTX-R3.1-DP-BAT-003.SLDPRT
cad/DronePlayground/WORKING/R3_1/CUSTOM/R3_3/Packaging/RTX-R3.3-DP-CAM-005_C220_Upper_G10_D8_0p254.SLDPRT
cad/DronePlayground/WORKING/R3_1/PLACEHOLDERS/R3_1/Holybro_15026_UBEC_CATALOG_ENVELOPE.SLDPRT
cad/DronePlayground/WORKING/R3_1/PLACEHOLDERS/R3_2/HT_T18L_11102069_Route_v2_APPROX.SLDPRT
cad/DronePlayground/WORKING/R3_1/PLACEHOLDERS/R3_2/Standard_Hardware/Wurth_960030042_M3x3_DIMENSIONAL_APPROX.SLDPRT
cad/DronePlayground/WORKING/R3_1/PLACEHOLDERS/R3_3/Transcend_TS512GMTE400S_2242_CATALOG_INTERFACE_RESERVATION.SLDPRT
cad/DronePlayground/Holybro_Pixhawk_Jetson/SOLID-24739_1.step.SLDPRT
cad/DronePlayground/WORKING/R3_1/CAD/CUSTOM/R01/Chassis/Frame_Spacer_M4_R01.SLDPRT
cad/DronePlayground/WORKING/R3_1/CAD/Gripper/START_HERE/Components/PLAY_695_Outer_Race_Seat_Shim.SLDPRT
cad/DronePlayground/WORKING/R3_1/CAD/Holybro_X650_Motor_Mount/Holybro_X650_Motor_Mount_Lower.SLDPRT
cad/DronePlayground/WORKING/R3_1/CAD/PLACEHOLDERS/ELP_USBGS1200P01_BH120_PH_Approx_Case_Lens_Bracket_QTY3.SLDPRT
cad/DronePlayground/WORKING/R3_1/CUSTOM/R3_1/Arms/RTX-R3.1-DP-GUARD-010.SLDPRT
cad/DronePlayground/WORKING/R3_1/CUSTOM/R3_1/Landing/RTX-R3.1-DP-LAND-001.SLDPRT
cad/DronePlayground/WORKING/R3_1/CUSTOM/R3_3/Packaging/RTX-R3.3-DP-CAM-003_C220_Service_Yoke.SLDPRT
cad/DronePlayground/WORKING/R3_1/PLACEHOLDERS/R3_1/Transcend_ESD310C_USB_SSD_CATALOG_ENVELOPE.SLDPRT
cad/DronePlayground/WORKING/R3_1/PLACEHOLDERS/R3_2/Standard_Hardware/Wurth_960040010_M2x4_DIMENSIONAL_APPROX.SLDPRT
cad/DronePlayground/WORKING/R3_1/PLACEHOLDERS/R3_2/VitalParts_HFF-M3-35-S5p5-ALU_DIMENSIONAL_APPROX.SLDPRT
cad/DronePlayground/WORKING/R3_1/PLACEHOLDERS/R3_3/Delock_64343_BrainChip_COMBINED_SPACE_ALLOCATION_APPROX.SLDPRT
cad/DronePlayground/WORKING/R3_1/CAD/CUSTOM/R01/Arms/Arm_Root_Lower_R01.SLDPRT
cad/DronePlayground/WORKING/R3_1/CAD/CUSTOM/R01/Chassis/CF_Centre_Plate_Upper_R01.SLDPRT
cad/DronePlayground/WORKING/R3_1/CAD/Gripper/START_HERE/Components/PLAY_Pivot_Retaining_Collar.SLDPRT
cad/DronePlayground/WORKING/R3_1/CUSTOM/R3_1/Arms/RTX-R3.1-DP-GUARD-015.SLDPRT
cad/DronePlayground/WORKING/R3_1/CUSTOM/R3_1/Hardware/M2p5_Locknut_AF5_H3_ENVELOPE.SLDPRT
cad/DronePlayground/WORKING/R3_1/CUSTOM/R3_1/Landing/RTX-R3.1-DP-LAND-003.SLDPRT
cad/DronePlayground/WORKING/R3_1/CUSTOM/R3_1/Packaging/RTX-R3.1-DP-CMP-001.SLDPRT
cad/DronePlayground/WORKING/R3_1/CUSTOM/R3_2/Packaging/RTX-R3.2-DP-PWR-012.SLDPRT
cad/DronePlayground/WORKING/R3_1/PLACEHOLDERS/R3_1/Tattu_TAS60006S95X9_CATALOG_ENVELOPE.SLDPRT
cad/DronePlayground/WORKING/R3_1/PLACEHOLDERS/R3_2/Battery_Grip_Pad_136x38x3_APPROX.SLDPRT
cad/DronePlayground/WORKING/R3_1/PLACEHOLDERS/R3_3/Holybro_SiK_V3_100mW_BODY_CATALOG.SLDPRT
cad/DronePlayground/WORKING/R3_1/CAD/CUSTOM/R01/Arms/CF_Spar_20x18_R01.SLDPRT
cad/DronePlayground/WORKING/R3_1/CUSTOM/R3_1/Arms/RTX-R3.1-DP-GUARD-009.SLDPRT
cad/DronePlayground/WORKING/R3_1/CUSTOM/R3_1/Hardware/M4_Compression_TopHat_8p5mm.SLDPRT
cad/DronePlayground/WORKING/R3_1/CUSTOM/R3_1/Landing/RTX-R3.1-DP-LAND-004.SLDPRT
cad/DronePlayground/WORKING/R3_1/CUSTOM/R3_1/Packaging/RTX-R3.1-DP-CAM-001.SLDPRT
cad/DronePlayground/WORKING/R3_1/CUSTOM/R3_3/Packaging/RTX-R3.3-DP-CAM-004_C220_Lower_G10_0p254.SLDPRT
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
