rohanbhadange/RTX-AVC-Design/(commit log)

2026-11-03 docs: record Jetson USB SiK integration and carrier USB2 allocation
2026-11-03 Archive saved C124 Drone Playground packaging baseline
    Preserve approved native CAD dependencies with Git LFS, density material library, historical C122 native views, attribution and asset hashes. Record unverified cross-machine portability and unfinished engineering integration; exclude uninstalled candidates.
    [0001_2.step.SLDPRT, 3D_PDB02-V1_1A_2024-12-06_ASM_1_ASM.step.SLDASM, 5OVZ-J20_ASM_1_ASM.step.SLDASM, 5OVZ-J21_ASM_1_ASM.step.SLDASM, 5OVZ-J22_ASM_1_ASM.step.SLDASM, 5OVZ-J23_ASM_1_ASM.step.SLDASM, 5OVZ-J24_ASM_1_ASM.step.SLDASM, 5OVZ-J25_ASM_1_ASM.step.SLDASM]
2026-11-03 snapshot: capture W-100 wiring state after SiK USB integration
2026-11-03 docs: log SiK USB wiring change, before-after counts and tests
2026-11-03 snapshot: reconcile final SiK USB port names and physical GH5 connector
2026-11-03 docs(wiring): commit current W-100 and W-101 diagrams from Wiring Studio
2026-11-03 snapshot(wiring): archive current W-101 power tree alongside diagrams
2026-11-03 docs(wiring): establish version-independent current snapshot for W-100
2026-11-03 docs(wiring): establish version-independent current snapshot for W-101
2026-11-03 tools(wiring): generate SVG wiring views and pin-level CSV netlists from snapshots
2026-11-03 ci(wiring): regenerate SVG diagrams and netlists when checked-in snapshots change
2026-11-03 docs(wiring): regenerate diagrams from current snapshots
    [W-100-netlist.csv, W-101-netlist.csv]
2026-11-03 docs(wiring): add diagram index, architecture views and synchronization procedure
2026-11-03 docs(wiring): normalize Markdown code delimiters
2026-11-03 docs: link current wiring diagrams and automatic export workflow from repository home
2026-11-03 tools(wiring): reproducible presentation crops of native W-100/W-101 diagrams
2026-11-03 ci(wiring): crop native diagram screenshots into slide-ready images
2026-11-03 docs(wiring): update presentation crops from Studio exports
2026-11-03 docs(wiring): tighten presentation crops around main power and USB/comms schematic
2026-11-03 Save C168 integrated power carrier checkpoint
    Install the saved carrier/module with preserved prior configuration, native reopen views and six-file hash manifest. Record 72 versus 80 mount pieces and approximately 19 g provisional density-equivalent reduction, while retaining engineering and portability holds.
    [DronePlayground.SLDASM, R3_3_Internal_Power_Carrier.SLDASM, RTX-R3.3-DP-PWR-013_Integrated_Carrier_Candidate02.SLDPRT]
2026-11-04 Save C180 SiK radio integration checkpoint
    Archive the reopened R3_3_RADIO_INTEGRATION main, integral compute/radio cradle, catalog radio body, retention approximations and native views. Preserve prior configurations/history and record scoped checks, provisional masses and remaining system/portability holds.
    [DronePlayground.SLDASM, Holybro_SiK_V3_100mW_BODY_CATALOG.SLDPRT, R3_3_Compute_Radio_Mount.SLDASM, RTX-R3.3-DP-CMP-004_Radio_Service_Clear.SLDPRT, Radio_Protective_Pad_1mm_APPROX.SLDPRT, T18L_Radio_Tie_Route_H3_APPROX.SLDPRT]
2026-11-04 Save C215 internal PM08 packaging WIP checkpoint
    [Delock_64343_BrainChip_COMBINED_SPACE_ALLOCATION_APPROX.SLDPRT, DronePlayground.SLDASM, R3_2_PM08_Cassette_Fastener_Kit.SLDASM, R3_3_Internal_Power_PM08.SLDASM, Transcend_TS512GMTE400S_2242_CATALOG_INTERFACE_RESERVATION.SLDPRT]
2026-11-05 Save C235 camera mount and shelf retirement WIP
    Preserve the exact D455 pose with the installed 16-piece service mount and configuration-specific lower plate holes, suppressing obsolete shelf and camera supports in the new configuration. Archive native views, materials and hash manifests with scoped reopen evidence and remaining physical/system holds.
    [CF_Centre_Plate_Lower_R01.SLDPRT, DronePlayground.SLDASM, R3_3_D455_Service_Mount.SLDASM, RTX-R3.3-DP-CAM-003_C220_Service_Yoke.SLDPRT, RTX-R3.3-DP-CAM-004_C220_Lower_G10_0p254.SLDPRT, RTX-R3.3-DP-CAM-005_C220_Upper_G10_D8_0p254.SLDPRT]
